mattybrad/drumkid2/media/images/panelimageexport.png

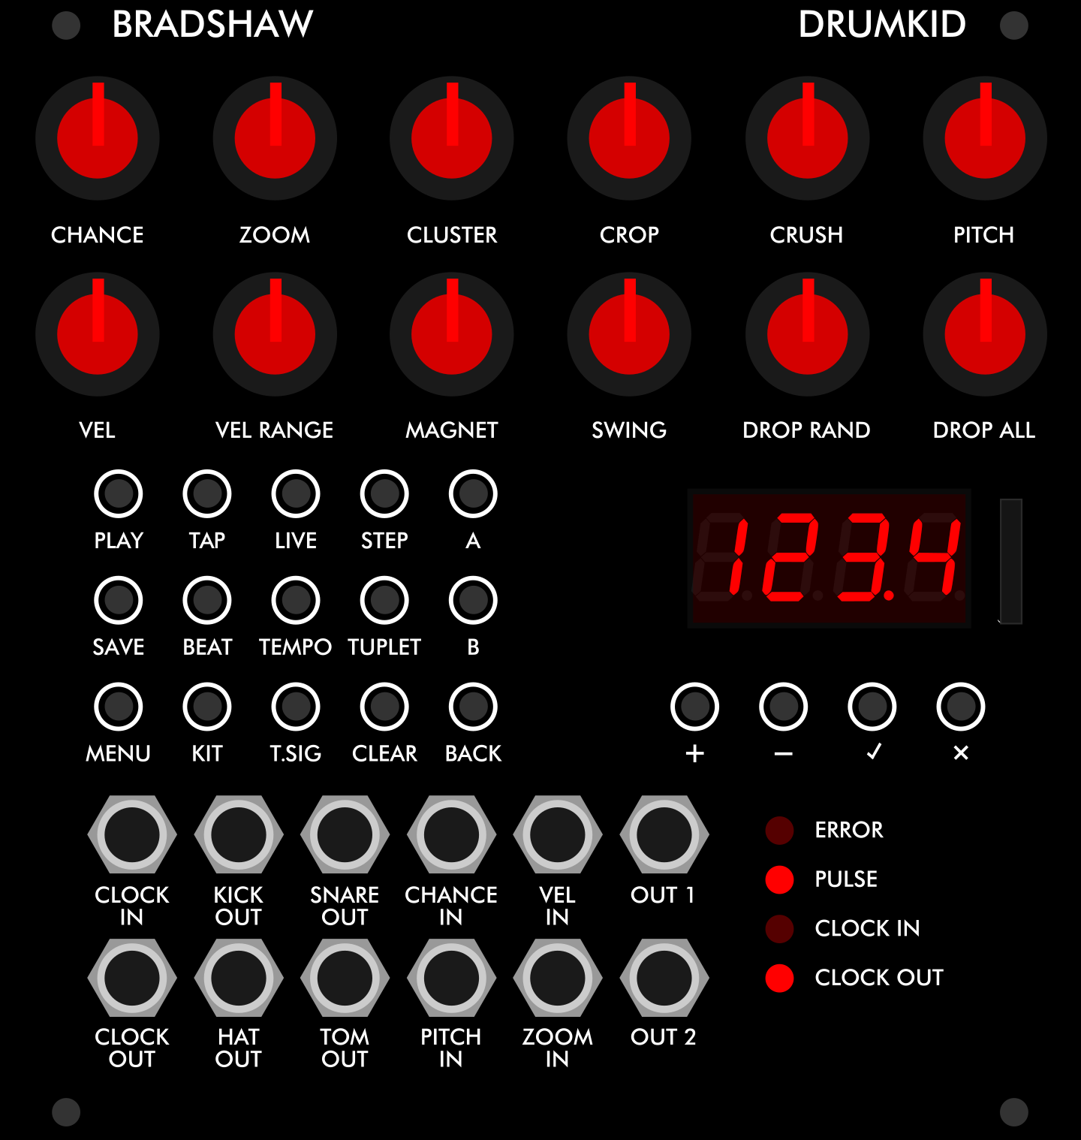
media/images/panelimageexport.png
