mattybrad/drumkid2/enclosure/eurorack/dk2_04_test.FCStd

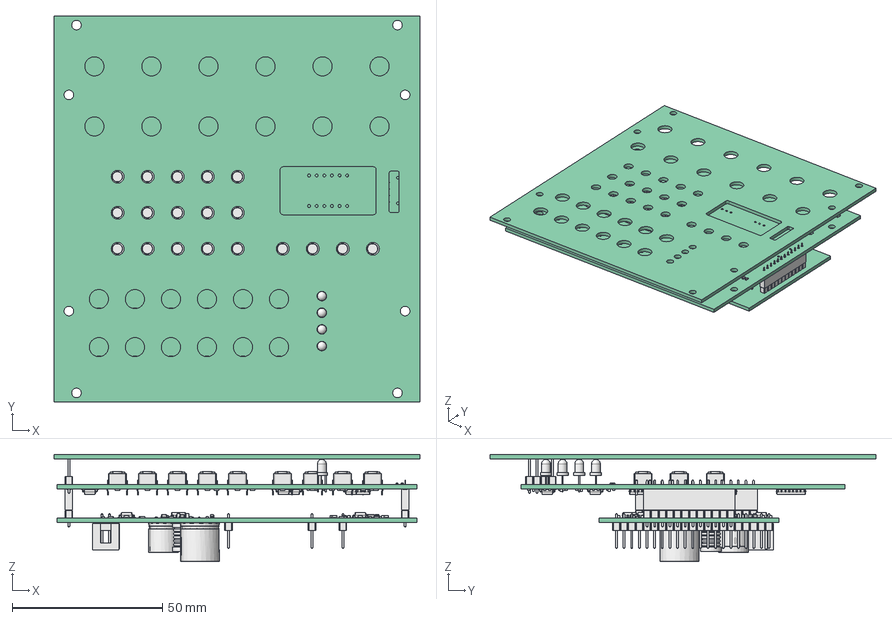
[picture p2: CAD file, 2025-03-11]
enclosure/eurorack/dk2_04_test.FCStd
121.9 x 128.5 x 35.8 mm
Pcb_6fe8
R11_R_0603_1608Metric_568fa190395a x 30
U4_TSSOP_20_44x65mm_P065mm_1e9c9b3e8fcb
U8_SOIC_8_39x49mm_P127mm_8803a6aed0f0 x 5
C3_C_0603_1608Metric_a1dab536839c x 25
J1_PinHeader_1x16_P254mm_Vertical_922e0c858e7e
D3_D_SOD_323_6214f62f95dd x 2
U2_SOT_23_0632b1590d94 x 2
J2_PinHeader_1x12_P254mm_Vertical_f6d6b4c187ef
C28_CP_Radial_D130mm_P500mm_ecaefe393f6c
J3_IDC_Header_2x05_P254mm_Vertical_50bdde54b574
L1_L_Radial_D7.0mm_P3.00mm_40ad14d131ec
J4_PinHeader_1x20_P254mm_Vertical_e00578f8c755 x 2
C27_CP_Radial_D80mm_P350mm_0c95952084c7
C25_CP_Radial_D100mm_P500mm_90115cc70ddc
J6_PinHeader_1x03_P254mm_Vertical_6c098004085a
Pcb_d942
SW10_SW_PUSH_6mm_a04f14d90740 x 19
D3_LED_D3.0mm_38c63c7e5b48 x 4
R45_R_0603_1608Metric_0fdf1b936cea x 45
J16_PinHeader_1x04_P254mm_Vertical_5d51ec4c8518
J7_PinSocket_1x12_P254mm_Vertical_d1941066af14
U6_SOIC_16_39x99mm_P127mm_10dee03ec1e1 x 7
C4_C_0603_1608Metric_d44bcf60c2ce x 4
J1_PinSocket_1x16_P254mm_Vertical_4846281b7eb6
U7_SOIC_8_39x49mm_P127mm_5dd7fafe9875 x 2
Pcb_edf2
