mattybrad/drumkid2/misc/displaypadtool/displaypadtool.FCStd

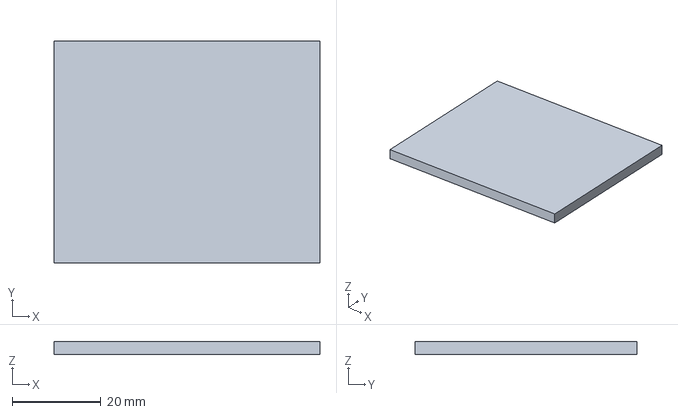
[picture p3: CAD file, 2025-08-04]
misc/displaypadtool/displaypadtool.FCStd
60.0 x 50.0 x 3.00 mm
