mattybrad/drumkid2/(list of files, cad)

Other CAD files:
pcb/dk2_06_panel/dk2_04_panel-F_Silkscreen.dxf
