mattybrad/drumkid2/code/bugs.txt

BUGS TO FIX
- Live beat input is not great, can't really do tuplets, kinda unreliable
- Rogue random hits with chance=0 and magnet>0 (and magnet<4095) with time signatures>4, drawing for wrong bit of memory...
- Metronome shouldn't be crushed?

FEATURES TO ADD
- Add 24PPQN (somehow) because it's common
- Live input undo?
- Separate trigger pulse length setting
- Program selection of default beats
- Finalise default kit and three(?) other kits for beta testers
- Dedicated back button?
- Live input quantize setting working
- Scrolling text for settings menu
POST-BETA FEATURES (non-essential)
- Reinitializing flash seems to leave vestige of old samples
- "Debouncing"(?) on drop pot, stays in current mode until definite change
- Fractional tempos (e.g. 120.1BPM)
- Allow stereo samples (load as mono)
- Allow other sample rates
- Backup beats to SD
- Better pitch lerping (not correct in reverse..?)
- Prioritise more recent(?) notes in reverse to give expected sound at higher zooms
- Use true midpoint of bizarrely asymmetrical pots! Like 1900/2000 rather than 2048?
