mattybrad/drumkid2/code/defaultsamples.h

#ifndef DEFAULTSAMPLES_H
#define DEFAULTSAMPLES_H

const int16_t defaultKick[] = {
    0,
    8,
    -44,
    485,
    2316,
    4103,
    5672,
    7048,
    8303,
    9439,
    10501,
    11486,
    12406,
    13282,
    14111,
    14932,
    15704,
    16433,
    17125,
    17773,
    18405,
    18995,
    19554,
    20094,
    20590,
    21078,
    21512,
    21940,
    22331,
    22713,
    23065,
    23398,
    23715,
    24008,
    24281,
    24539,
    24763,
    24995,
    25193,
    25372,
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
};

const int16_t defaultSnare[] = {
    29,
    159,
    283,
    -81,
    -587,
    523,
    3636,
    5972,
    4977,
    1540,
    -1683,
    -3526,
    -4632,
    -5617,
    -6289,
    -6286,
    -5608,
    -4499,
    -3176,
    -1831,
    -657,
    264,
    1033,
    1796,
    2531,
    3032,
    3145,
    2984,
    2875,
    3086,
    3628,
    4253,
    4605,
    4448,
    3835,
    3039,
    2311,
    1713,
    1199,
    774,
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
};

const int16_t defaultHat[] = {
    13,
    -143,
    -98,
    5,
    428,
    638,
    -478,
    -560,
    1136,
    1807,
    1305,
    -163,
    -2225,
    -2879,
    -420,
    2715,
    1925,
    -2138,
    -3389,
    -507,
    1587,
    1154,
    -1315,
    -2266,
    1587,
    3539,
    458,
    -1095,
    -3389,
    -5127,
    2475,
    7833,
    1501,
    -3852,
    -1933,
    460,
    180,
    -588,
    -1854,
    -1802,
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
};

const int16_t defaultTom[] = {
    -78,
    -51,
    -83,
    -21,
    -78,
    1577,
    4791,
    7761,
    10499,
    12741,
    14594,
    16010,
    17106,
    17891,
    18467,
    18824,
    19023,
    19127,
    19124,
    19050,
    18935,
    18756,
    18558,
    18327,
    18086,
    17811,
    17531,
    17241,
    16938,
    16632,
    16311,
    15992,
    15668,
    15336,
    15000,
    14663,
    14321,
    13979,
    13635,
    13287,
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
};

const int16_t* defaultSamples[4] = {defaultKick, defaultSnare, defaultHat, defaultTom};
int16_t defaultSampleSizes[4] = {
    sizeof(defaultKick) / 2,
    sizeof(defaultSnare) / 2,
    sizeof(defaultHat) / 2,
    sizeof(defaultTom) / 2,
};

#endif
