mattybrad/drumkid2/firmware/dkeuro2/hardware/Leds.cpp

#include "Leds.h"
#include "Config.h"
#include "sn74595.pio.h"
#include "hardware/Pins.h"
#include "hardware/gpio.h"

Leds* Leds::_instance = nullptr;

void Leds::init() {
    _instance = this;
    // Initialize LED hardware
    gpio_init(Pins::SR_OUT_DATA);
    gpio_set_dir(Pins::SR_OUT_DATA, GPIO_OUT);
    gpio_init(Pins::SR_OUT_CLOCK);
    gpio_set_dir(Pins::SR_OUT_CLOCK, GPIO_OUT);
    gpio_init(Pins::SR_OUT_LATCH);
    gpio_set_dir(Pins::SR_OUT_LATCH, GPIO_OUT);
    sn74595::shiftreg_init();
    _singleLedStates = 0;
    _segmentData[0] = 0b11000000;
    _segmentData[1] = 0b00110000;
    _segmentData[2] = 0b00001100;
    _segmentData[3] = 0b00000011;
}

void Leds::setLed(uint8_t ledNum, bool state) {
    // Set individual LED state
    if(state) {
        _singleLedStates |= (1 << (3-ledNum));
    } else {
        _singleLedStates &= ~(1 << (3-ledNum));
    }
}

void Leds::sendLedPulse(uint8_t ledNum, absolute_time_t startTimeUs) {
    if(ledNum >= NUM_LEDS) return;

    void *userData = (void*)(uintptr_t)ledNum;
    add_alarm_at(startTimeUs, _alarmCallbackHigh, userData, true);
    add_alarm_at(startTimeUs + (_pulseLengthMs * 1000), _alarmCallbackLow, userData, true);
}

int64_t Leds::_alarmCallbackHigh(alarm_id_t id, void* userData) {
    uint8_t ledNum = (uint8_t)(uintptr_t)userData;
    _instance->setLed(ledNum, true);

    return 0; // no need to repeat
}

int64_t Leds::_alarmCallbackLow(alarm_id_t id, void* userData) {
    uint8_t ledNum = (uint8_t)(uintptr_t)userData;
    _instance->setLed(ledNum, false);

    return 0; // no need to repeat
}

void Leds::setDisplayDigit(uint8_t digitNum, uint8_t digitSegmentData) {
    // Set 7-segment display data
    if(digitNum < 4) {
        _segmentData[digitNum] = digitSegmentData;
    }
}

void Leds::setDisplayString(const char* str) {
    bool stringFinished = false;
    for(uint8_t i=0; i<4; i++) {
        if(str[i] == '\0') stringFinished = true;
        setDisplayDigit(i, stringFinished ? 0 : asciiChars[(uint8_t)str[i]]);
    }
}

void Leds::setDisplayInt(int32_t number) {
    // Display integer on 7-segment display
    
    // todo: handle negative and >9999

    for(uint8_t i=0; i<4; i++) {
        uint8_t digitValue = number % 10;
        if(number == 0 && i > 0) {
            setDisplayDigit(3-i, asciiChars[0]); // leading zeros as blank
        } else {
            setDisplayDigit(3-i, asciiChars['0' + digitValue]);
        }
        number /= 10;
    }
}

void Leds::setDisplayNumberFP(int32_t numberFP, uint8_t decimalPlaces) {
    // Display fixed point number on 7-segment display, with specified decimal places
    int32_t adjustedNumber = numberFP;
    for(uint8_t i=0; i<decimalPlaces; i++) {
        adjustedNumber *= 10;
    }
    adjustedNumber = adjustedNumber >> 16;
    for(uint8_t i=0; i<4; i++) {
        uint8_t digitValue = adjustedNumber % 10;
        bool isDecimalPoint = (i == decimalPlaces && decimalPlaces > 0);
        bool isLeadingZero = (adjustedNumber == 0 && i >= decimalPlaces);
        setDisplayDigit(3-i, asciiChars[isLeadingZero ? 0 : '0' + digitValue] + (isDecimalPoint ? 0b10000000 : 0)); // add decimal point to appropriate digit
        adjustedNumber /= 10;
    }
} 

void Leds::update() {
    // Update LED states on hardware
    // first 8 bits toggle segments, next 4 bits toggle digits, last 4 bits toggle LEDs
    uint16_t shiftRegData = 0b0000111100000000;
    shiftRegData |= (_singleLedStates << 12);
    shiftRegData |= _segmentData[_currentDigit];
    shiftRegData &= ~(1 << (8+_currentDigit)); // set selected digit low
    sn74595::shiftreg_send(shiftRegData);
    _currentDigit = (_currentDigit + 1) % 4;
    _lastUpdateTime = time_us_64();
}

void Leds::specialUpdateBeforeBlockingProcess() {
    // sets all digits to "_" to indicate processing
    uint16_t shiftRegData = 0b0000000000001000;
    shiftRegData |= (_singleLedStates << 12);
    sn74595::shiftreg_send(shiftRegData);
}

int64_t Leds::lastUpdate() {
    return _lastUpdateTime;
}

uint8_t Leds::asciiChars[] = {
    0b00000000, // 0 NULL
    0b00000000,
    0b00000000,
    0b00000000,
    0b00000000,
    0b00000000,
    0b00000000,
    0b00000000,
    0b00000000,
    0b00000000,
    0b00000000,
    0b00000000,
    0b00000000,
    0b00000000,
    0b00000000,
    0b00000000,
    0b00000000,
    0b00000000,
    0b00000000,
    0b00000000,
    0b00000000,
    0b00000000,
    0b00000000,
    0b00000000,
    0b00000000,
    0b00000000,
    0b00000000,
    0b00000000,
    0b00000000,
    0b00000000,
    0b00000000,
    0b00000000,
    0b00000000, // 32 SPACE
    0b00000000,
    0b00000000,
    0b00000000,
    0b00000000,
    0b00000000,
    0b00000000,
    0b00000000,
    0b00000000,
    0b00000000,
    0b00000000,
    0b00000000,
    0b00000000,
    0b01000000, // -
    0b10000000, // .
    0b00000000,
    0b00111111, // digit 0
    0b00000110,
    0b01011011,
    0b01001111,
    0b01100110,
    0b01101101,
    0b01111101,
    0b00000111,
    0b01111111,
    0b01101111, // digit 9
    0b00000000,
    0b00000000,
    0b00000000,
    0b00000000,
    0b00000000,
    0b01010011,
    0b00000000, // 64
    0b01110111, // A (a)
    0b01111100,
    0b00111001,
    0b01011110,
    0b01111001,
    0b01110001,
    0b01101111,
    0b01110110,
    0b00000110,
    0b00001111,
    0b01110110,
    0b00111000,
    0b00110111,
    0b01010100,
    0b01011100,
    0b01110011,
    0b01100111,
    0b01010000,
    0b01101101,
    0b01111000,
    0b00111110,
    0b00011100,
    0b00111110,
    0b01110110,
    0b01101110,
    0b01011011, // Z (z)
    0b00000000,
    0b00000000,
    0b00000000,
    0b00000000,
    0b00001000, // _
    0b00000000, // 96
    0b01110111, // a
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
};
