mattybrad/drumkid2/code/defaultbeats.h

#ifndef DEFAULTBEATS_H
#define DEFAULTBEATS_H

#define NUM_DEFAULT_BEATS 24

constexpr uint32_t defaultBeats[NUM_DEFAULT_BEATS][NUM_SAMPLES] = {
    {
        0b00000000000000000000000000000000,
        0b00000000000000000000000000000000,
        0b10001000100010001000100010001000,
        0b00000000000000000000000000000000,
    },
    {
        0b00000000000000000000000000000000,
        0b00000000000000000000000000000000,
        0b10101010101010101010101010101010,
        0b00000000000000000000000000000000,
    },
    {
        0b10000000100000000000000000000000,
        0b00001000000010000000000000000000,
        0b10101010101010101010101010101010,
        0b00000000000000000000000000000000,
    },
    {
        0b10000000000000000000000000000000,
        0b00000000100000000000000000000000,
        0b10001000100010001000100010001000,
        0b00000000000000000000000000000000,
    },
    { // there there
        0b10000010001000001000001000100000,
        0b00001000000010000000100000001000,
        0b10101010101010101010101010101010,
        0b00001000000010000000100000001000,
    },
    { // metal
        0b11110111111101111111011111110111,
        0b00001000000010000000100000001000,
        0b10001000100010001000100010001000,
        0b00000000000000000000000000000000,
    },
    { // four to the floor
        0b10001000100010001000100010001000,
        0b00000000000000000000000000000000,
        0b00000000000000000000000000000000,
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
    },
    { // nihil (could possibly remove this to save some bytes)
        0b00000000000000000000000000000000,
        0b00000000000000000000000000000000,
        0b00000000000000000000000000000000,
        0b00000000000000000000000000000000,
    },
};

#endif
