mattybrad/drumkid2/firmware/dkeuro2/interface/Menu.h

#pragma once
#include <array>
#include "hardware/Leds.h"
#include "hardware/Memory.h"
#include "hardware/CardReader.h"
#include "audio/KitManager.h"
#include "rhythm/Transport.h"
#include "Config.h"

enum class MenuState {
    HOME,
    TAP_TEMPO,
    LIVE_EDIT,
    STEP_EDIT,
    BEAT_SELECT,
    MANUAL_TEMPO,
    TUPLET_SELECT,
    SUBMENU_SELECTING,
    INPUT_PPQN_SELECT,
    OUTPUT_PPQN_SELECT,
    CLOCK_MODE_SELECT,
    KIT_LOAD_FOLDER_SELECT,
    KIT_LOAD_SLOT_SELECT,
    KIT_DELETE,
    KIT_SELECT,
    TIME_SIGNATURE_SELECT,
    CHECK_SPACE
};


class Menu {
    public:
        void init(Leds* leds, Memory* memory, CardReader* cardReader, KitManager* kitManager, Transport* transport);
        void handleButtonPress(int16_t buttonIndex);
        void forceDisplayUpdate();
    
    private:
        Leds* _leds = nullptr;
        Memory* _memory = nullptr;
        CardReader* _cardReader = nullptr;
        KitManager* _kitManager = nullptr;
        Transport* _transport = nullptr;
    
        MenuState _state = MenuState::HOME;
        uint8_t _subMenuIndex = 0;
        uint16_t _kitLoadFolderIndex = 0;
        uint16_t _kitLoadSlot = 0;
        std::array<MenuState, 6> _subMenuStates = {
            MenuState::CLOCK_MODE_SELECT,
            MenuState::KIT_LOAD_FOLDER_SELECT,
            MenuState::KIT_DELETE,
            MenuState::CHECK_SPACE,
            MenuState::INPUT_PPQN_SELECT,
            MenuState::OUTPUT_PPQN_SELECT,
        };

        void _handleButtonGeneral(int16_t buttonIndex);
        void _handleButtonKitSelect(int16_t buttonIndex);
        void _handleButtonManualTempo(int16_t buttonIndex);
        void _handleButtonSubMenuSelecting(int16_t buttonIndex);
        void _handleButtonKitLoadFolderSelect(int16_t buttonIndex);
        void _handleButtonKitLoadSlotSelect(int16_t buttonIndex);
        void _handleButtonKitDelete(int16_t buttonIndex);
        void _handleButtonCheckSpace(int16_t buttonIndex);
        void _handleButtonClockModeSelect(int16_t buttonIndex);
        void _handleButtonTimeSignatureSelect(int16_t buttonIndex);
        void _updateDisplay();
};
