mattybrad/drumkid2/(commit log)

2022-09-08 pico submodules
2022-09-08 pico pcb
    [dk2_00.kicad_pcb, dk2_00.kicad_sch]
2023-01-16 figuring out specs
    [dk2_00.kicad_sch]
2023-01-17 good progress on schematic
    [dk2_00.kicad_sch]
2023-01-17 more schematic progress
    [dk2_00.kicad_sch]
2023-01-18 even more schematic
    [dk2_00.kicad_sch]
2023-02-07 something, can't remember
    [dk2_00.kicad_sch]
2023-04-11 haven't committed for a while...
    [dk2_00.kicad_sch]
2023-04-11 did some things
    [dac.kicad_sch, dk2_00.kicad_sch, midi.kicad_sch, muxin.kicad_sch, shiftregin.kicad_sch, shiftregout.kicad_sch, sync.kicad_sch]
2023-04-20 i'm back!
    [dac.kicad_sch, dk2_00.kicad_sch, midi.kicad_sch, muxin.kicad_sch, shiftregin.kicad_sch, shiftregout.kicad_sch, sync.kicad_sch]
2023-04-20 eurorack thoughts
    [cv.kicad_sch, dk2_00.kicad_sch, sync.kicad_sch]
2023-04-21 oh that's what a multi unit symbol is
    [dac.kicad_sch, dk2_00.kicad_sch, midi.kicad_sch, muxin.kicad_sch, shiftregin.kicad_sch, shiftregout.kicad_sch, sync.kicad_sch]
2023-04-21 not many errors
    [dac.kicad_sch, dk2_00.kicad_sch, midi.kicad_sch, muxin.kicad_sch, shiftregin.kicad_sch, shiftregout.kicad_sch, sync.kicad_sch]
2023-04-23 footprints assigned
    [dac.kicad_sch, dk2_00.kicad_pcb, dk2_00.kicad_sch, midi.kicad_sch, muxin.kicad_sch, shiftregin.kicad_sch, shiftregout.kicad_sch, sync.kicad_sch]
2023-04-25 changed jack sockets
    [dac.kicad_sch, dk2_00.kicad_pcb, midi.kicad_sch, sync.kicad_sch]
2023-04-25 eurorack power stuff
    [dk2_00.kicad_sch, europower.kicad_sch, sync.kicad_sch]
2023-04-27 power things?
    [dk2_00.kicad_sch, europower.kicad_sch]
2023-04-27 making a mess
    [cv_in.kicad_sch, cv_out.kicad_sch, dk2_00.kicad_sch, europower.kicad_sch]
2023-04-28 nothing much
    [cv_in.kicad_sch, cv_out.kicad_sch]
2023-05-02 being decisive
    [dac.kicad_sch, europower.kicad_sch, midi.kicad_sch, shiftregin.kicad_sch, shiftregout.kicad_sch, sync.kicad_sch]
2023-05-02 eurorack audio out
    [dac.kicad_sch, dk2_00.kicad_sch, muxin.kicad_sch]
2023-05-03 i'm doing electronics!
    [dac.kicad_sch, dk2_00.kicad_sch, muxin1.kicad_sch, muxin2.kicad_sch]
2023-05-04 tidying up, getting close!
    [dac.kicad_sch, dk2_00.kicad_sch, europower.kicad_sch, midi.kicad_sch, muxin1.kicad_sch, muxin2.kicad_sch, shiftregin.kicad_sch, shiftregout.kicad_sch]
2023-05-04 barrel jack, power pins
    [dk2_00.kicad_sch, muxin2.kicad_sch, power.kicad_sch]
2023-05-04 rough layout
    [dk2_00.kicad_pcb, muxin1.kicad_sch]
2023-05-05 this layout is complicated!
    [dac.kicad_sch, dk2_00.kicad_pcb, dk2_00.kicad_sch, midi.kicad_sch, muxin2.kicad_sch, power.kicad_sch, sync.kicad_sch]
2023-05-05 more layout
    [dk2_00.kicad_pcb]
2023-05-15 getting there with the layout
    [dk2_00.kicad_pcb]
2023-05-17 about to start routing i guess?
    [dk2_00.kicad_pcb]
2023-05-17 161 still unrouted
    [dk2_00.kicad_pcb]
2023-05-17 76 unrouted
    [dk2_00.kicad_pcb]
2023-05-18 only 12 unrouted but discovered a mistake
    [dk2_00.kicad_pcb]
2023-05-18 zero unconnected!
    [dac.kicad_sch, dk2_00.kicad_pcb]
2023-05-21 tidied up layout
    [dk2_00.kicad_pcb]
2023-05-23 it's jlc time
    [dac.kicad_sch, dk2_00.kicad_pcb, dk2_00.kicad_sch, midi.kicad_sch, muxin2.kicad_sch, power.kicad_sch, sync.kicad_sch]
2023-05-23 nearly there with jlcpcb, one footprint was wrong
    [dac.kicad_sch, dk2_00.kicad_pcb]
2023-05-23 faffing with bom
2023-05-31 ordered PCBs, mistake on MIDI input optocoupler
    [midi.kicad_sch]
2023-06-05 logging some broken/modded stuff now the pcb is working
    [dac.kicad_sch, dk2_00.kicad_sch, power.kicad_sch, sync.kicad_sch]
2023-06-07 it plays samples!
2023-06-08 testing board in c
    [shiftregin.kicad_sch]
2023-06-08 cv pitch shifting working
2023-06-16 some weird timing error with LEDs but promising nonetheless
    [Beat.h, dk.cpp]
2023-06-16 leds working nicely
2023-06-19 making led and button functions a bit nicer
2023-06-20 solved temperamental 4051 readings
    [muxin1.kicad_sch, muxin2.kicad_sch]
2023-08-15 started eurorack pcb
    [cv.kicad_sch, cv_in.kicad_sch, cv_out.kicad_sch, dac.kicad_sch, dk2_01.kicad_pcb, dk2_01.kicad_sch, europower.kicad_sch, midi.kicad_sch]
2023-08-15 good pcb progress
    [dac.kicad_sch, dk2_01.kicad_sch, muxin1.kicad_sch, muxin2.kicad_sch, shiftregout.kicad_sch, sync.kicad_sch]
2023-08-15 going for a picnic
    [dac.kicad_sch, dk2_01.kicad_pcb, dk2_01.kicad_sch, muxin1.kicad_sch, muxin2.kicad_sch, power.kicad_sch, shiftregin.kicad_sch, shiftregout.kicad_sch]
2023-08-16 pcb layout going well
    [dac.kicad_sch, dk2_01.kicad_pcb, dk2_01.kicad_sch, muxin2.kicad_sch, power.kicad_sch, shiftregout.kicad_sch, sync.kicad_sch]
2023-08-16 there is a lot of stuff on this pcb
    [dk2_01.kicad_pcb]
2023-08-16 tweaking the front panel based on the pcb
    [dac.kicad_sch, dk2_01.kicad_pcb, muxin2.kicad_sch, sync.kicad_sch]
2023-08-16 more layout tweaks
    [dk2_01.kicad_pcb, power.kicad_sch, shiftregout.kicad_sch]
2023-08-21 changing design to double-decker pcb for compactness
    [cv.kicad_sch, cv_in.kicad_sch, cv_out.kicad_sch, dac.kicad_sch, digital-in-out.kicad_sch, dk2_02_bottom.kicad_pcb, dk2_02_bottom.kicad_sch, europower.kicad_sch]
2023-08-23 bottom pcb looks fairly easy
    [dac.kicad_sch, digital-in-out.kicad_sch, dk2_02_bottom.kicad_pcb, dk2_02_bottom.kicad_sch, power.kicad_sch]
2023-08-23 started top side pcb
    [cv.kicad_sch, cv_in.kicad_sch, cv_out.kicad_sch, dac.kicad_sch, dk2_02_bottom.kicad_pcb, dk2_02_top.kicad_pcb, dk2_02_top.kicad_sch, europower.kicad_sch]
2023-08-23 done for the week, started routing
    [dac.kicad_sch, dk2_02_bottom.kicad_pcb, dk2_02_bottom.kicad_sch, dk2_02_top.kicad_pcb, dk2_02_top.kicad_sch, muxin2.kicad_sch]
2023-08-29 routing again
    [dk2_02_top.kicad_pcb]
2023-08-29 nearly routed
    [dk2_02_top.kicad_pcb]
2023-08-29 top routing done
    [dk2_02_bottom.kicad_pcb, dk2_02_top.kicad_pcb, dk2_02_top.kicad_sch]
2023-08-29 started component placement on bottom board
    [dk2_02_bottom.kicad_pcb]
2023-08-30 bottom pcb placement done
    [dk2_02_bottom.kicad_pcb]
2023-08-30 bottom routing mainly done
    [dk2_02_bottom.kicad_pcb]
2023-08-30 routing done
    [dk2_02_bottom.kicad_pcb]
2023-08-30 ready for jlcpcb
    [dk2_02_bottom-CuBottom.gbr, dk2_02_bottom-CuTop.gbr, dk2_02_bottom-EdgeCuts.gbr, dk2_02_bottom-MaskBottom.gbr, dk2_02_bottom-MaskTop.gbr, dk2_02_bottom-NPTH.drl, dk2_02_bottom-PTH.drl, dk2_02_bottom-PasteBottom.gbr]
2023-09-05 panel nearly done
    [dk2_02_panel.kicad_pcb, dk2_02_panel.kicad_sch]
2023-09-05 front panel done
    [dk2_02_panel-CuBottom.gbr, dk2_02_panel-CuTop.gbr, dk2_02_panel-EdgeCuts.gbr, dk2_02_panel-MaskBottom.gbr, dk2_02_panel-MaskTop.gbr, dk2_02_panel-NPTH.drl, dk2_02_panel-PTH.drl, dk2_02_panel-PasteBottom.gbr]
2023-10-11 assembling the pcb 2.02
    [dac.kicad_sch]
2023-10-18 pcb looking good so far
2023-11-08 sd sample loading works (messy for now)
2023-11-08 LEDs working much better now
2023-11-10 input/output handling now done with timers, much cleaner
2023-11-17 started flash storage stuff, hitting usb conflict issues?
    [dk.cpp]
2023-11-21 upgraded to the latest pico toolchain and tidied up code directory
2023-11-21 restored samples
2023-11-28 mainly fixed SD conflict
    [drumkid.cpp]
2023-11-28 sample loading from WAV file works really nicely!
2023-11-28 currently a mess, trying to move samples to flash
2023-12-04 figured out the flash erase issue
    [drumkid.cpp]
2023-12-04 now loading entire sample set from SD to flash to RAM
2023-12-05 tempo now stored when beat stops, also some bugfixes
    [drumkid.cpp, drumkid.h]
2023-12-12 reworking the hit scheduling system to allow swing and random timing
    [drumkid.cpp, drumkid.h]
2024-01-08 tired evening coding
2024-01-16 trying to find an annoying bug, making a mess
    [Sample.h, drumkid.cpp]
2024-01-22 fixed issue with initial hits on start
    [Sample.h, drumkid.cpp]
2024-01-22 sync out timing fixed
    [drumkid.cpp]
2024-01-23 replaced janky timer system with proper alarm pool stuff
    [Sample.h, drumkid.cpp, drumkid.h]
2024-01-30 can handle longer samples
2024-02-06 fixed tuplet map for beats
    [Beat.h, constants.h, drumkid.h]
2024-02-09 finding/fixing(?) some high-speed bugs
    [dac.kicad_sch, dk2_02_top.kicad_sch, shiftregout.kicad_sch]
2024-02-09 started adding pitch functionality, was too slow, need to rethink
    [Sample.h, drumkid.cpp, drumkid.h]
2024-02-12 switched sample position/speed stuff from floats to ints
2024-02-12 lerping! much better pitch effect
2024-02-12 reverse sample playback
2024-02-16 temporarily removing velocity functions to stress test scheduling speed
2024-02-27 reimplemented pitch, fixed fade out
    [Sample.h, constants.h, drumkid.cpp, drumkid.h]
2024-02-27 started trying to figure out reverse sample offset, got tired
    [Sample.h, drumkid.cpp, drumkid.h]
2024-03-04 successfully loaded 8 samples but tempo slowed down
2024-03-05 started pitch dead zone
2024-03-19 negative velocity
2024-03-26 more robust sd card error handling etc
    [drumkid.cpp, drumkid.h]
2024-04-10 ppqn output setting, clear current beat
2024-05-17 pitch knob behaviour improvement
    [muxin1.kicad_sch]
2024-05-17 better chance implementation, first attempt at magnet
2024-05-22 so close to magnet function working but not quite right with discontinuity right now
2024-05-24 magnet works okay
2024-05-31 revert beat to previous saved version
    [drumkid.cpp, drumkid.h]
2024-05-31 new bottom pcb
    [cv.kicad_sch, cv_in.kicad_sch, cv_out.kicad_sch, dac.kicad_sch, digital-in-out.kicad_sch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]
2024-06-03 alphabetical sample folder listing
2024-06-04 bootup visuals, error handling, status LEDs
    [drumkid.cpp, drumkid.h]
2024-06-06 led pulse length fix
    [drumkid.cpp, drumkid.h]
2024-06-28 getting ready for next PCBs
    [cv.kicad_sch, cv_in.kicad_sch, cv_out.kicad_sch, dac.kicad_sch, dk2_03_bottom.kicad_pcb, dk2_03_bottom.kicad_sch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]
2024-07-01 pcb progress
    [dk2_03_bottom.kicad_sch, dk2_03_top.kicad_sch, power.kicad_sch, shiftregin.kicad_sch, shiftregout.kicad_sch]
2024-07-02 bottom pcb shrunk
    [dk2_03_bottom.kicad_pcb, dk2_03_bottom.kicad_sch, dk2_03_top.kicad_sch]
2024-07-02 a commit before i mess up all the buttons
    [dac.kicad_sch, digital-in-out.kicad_sch, dk2_03_bottom.kicad_pcb, dk2_03_bottom.kicad_sch, dk2_03_top.kicad_pcb, dk2_03_top.kicad_sch, power.kicad_sch, shiftreginx.kicad_sch]
2024-07-05 routing top pcb
    [dk2_03_top.kicad_pcb, dk2_03_top.kicad_sch, muxin1.kicad_sch, muxin2.kicad_sch, shiftregin.kicad_sch, shiftreginx.kicad_sch, shiftregout.kicad_sch]
2024-07-05 top pcb routed
    [dk2_03_top.kicad_pcb, dk2_03_top.kicad_sch]
2024-07-05 routing bottom pcb
    [dk2_03_bottom.kicad_pcb, dk2_03_top.kicad_pcb]
2024-07-08 bottom pcb routed
    [dk2_03_bottom.kicad_pcb]
2024-07-08 front panel progress
    [dk2_03_panel-CuBottom.gbr, dk2_03_panel-CuTop.gbr, dk2_03_panel-EdgeCuts.gbr, dk2_03_panel-MaskBottom.gbr, dk2_03_panel-MaskTop.gbr, dk2_03_panel-NPTH.drl, dk2_03_panel-PTH.drl, dk2_03_panel-PasteBottom.gbr]
2024-07-08 fixed an issue where i forgot to rotate the pots on the pcb
    [dk2_03_panel.kicad_pcb, dk2_03_panel.kicad_sch, dk2_03_top.kicad_pcb]
2024-07-08 panel very nearly done
    [dk2_03_panel.kicad_pcb, dk2_03_panel.kicad_sch]
2024-07-09 panel finished!
    [dk2_03_panel.kicad_pcb, dk2_03_panel.kicad_sch]
2024-07-09 pcbs ordered
    [dk2_03_bottom-CuBottom.gbr, dk2_03_bottom-CuTop.gbr, dk2_03_bottom-EdgeCuts.gbr, dk2_03_bottom-MaskBottom.gbr, dk2_03_bottom-MaskTop.gbr, dk2_03_bottom-NPTH.drl, dk2_03_bottom-PTH.drl, dk2_03_bottom-PasteBottom.gbr]
2024-07-23 fixed sync out tuplet issue
    [drumkid.cpp]
2024-08-20 some good timing stability improvements
    [Sample.h, drumkid.cpp]
2024-08-23 tried something, it didn't work
    [drumkid.cpp, drumkid.h]
2024-09-03 things are not working well
    [drumkid.cpp]
2024-09-20 flash beat storage getting there, also sample loading
2024-09-27 slightly bodged sync output
    [drumkid.cpp]
2024-09-30 ppqn stuff and glitch effect
    [drumkid.cpp]
2024-10-04 button hold
2024-10-07 backup or revert beat
    [drumkid.cpp]
2024-10-14 restored velocity
2024-11-05 allowing other sample formats
2024-11-05 lower sample rates working
2024-11-05 added sample tails to reduce pop/click sounds
2024-11-18 figuring out how to do factory reset
    [Beat.h, defaultbeats.h, defaultsamples.h, drumkid.cpp, drumkid.h, sevensegcharacters.h]
2024-11-19 pot centre deadzones, fixed pulse display issue
    [drumkid.cpp, drumkid.h]
2024-11-22 magnet control working (that was annoying)
2024-11-22 fractional tempos, magnet fix
    [drumkid.cpp, drumkid.h]
2024-11-25 finally got button debouncing working properly
2024-11-26 fixed factory reset function
    [drumkid.cpp, drumkid.h]
2024-11-26 committing before i start messing about too much with timing stuff
    [drumkid.cpp]
2024-12-06 next pcb started
    [cv.kicad_sch, cv_in.kicad_sch, cv_out.kicad_sch, dac.kicad_sch, digital-in-out.kicad_sch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]
2024-12-10 power off stuff
    [dac.kicad_sch, digital-in-out.kicad_sch, dk2_04_bottom.kicad_sch, power.kicad_sch]
2024-12-13 pcb 2.04 tweaks
    [dk2_04_bottom.kicad_sch, power.kicad_sch, shiftreginx.kicad_sch]
2024-12-13 sample... samples
2025-02-17 panel improvements
    [dk2_04_panel.kicad_pcb, dk2_04_panel.kicad_sch]
2025-02-19 rejigged top board, smaller connectors
    [dk2_04_top.kicad_pcb, dk2_04_top.kicad_sch, shiftreginx.kicad_sch]
2025-03-11 autosave works
    [cv.kicad_sch, cv_in.kicad_sch, cv_out.kicad_sch, dac.kicad_sch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]
2025-03-19 making some progress on default samples without sd card
2025-05-15 haven't committed for ages because i did something stupid in git
    [cv.kicad_sch, cv_in.kicad_sch, cv_out.kicad_sch, dac.kicad_sch, digital-in-out.kicad_sch, digitalinout.kicad_sch, dk2_04_panel-F_Silkscreen.dxf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]
2025-05-15 all this layout stuff better be worth it
    [dac.kicad_sch, dk2_05.kicad_pcb, dk2_05_panel.kicad_pcb]
2025-05-15 layout starting to feel okay, routing will be bad..?
    [dk2_05.kicad_pcb]
2025-05-16 panel and pcb are aligned
    [dac.kicad_sch, digitalinout.kicad_sch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]
2025-05-16 started routing
    [dk2_05.kicad_pcb]
2025-05-19 routing going well
    [dk2_05.kicad_pcb]
2025-05-19 more routing
    [dk2_05.kicad_pcb]
2025-05-19 27 unrouted, nearly there...
    [dk2_05.kicad_pcb]
2025-05-20 jlcpcb stuff done
    [dk2_05-CuBottom.gbr, dk2_05-CuIn1.gbr, dk2_05-CuIn2.gbr, dk2_05-CuTop.gbr, dk2_05-EdgeCuts.gbr, dk2_05-MaskBottom.gbr, dk2_05-MaskTop.gbr, dk2_05-NPTH.drl]
2025-05-20 faffing with capacitors for jlc reasons
    [cv.kicad_sch, cv_in.kicad_sch, cv_out.kicad_sch, dac.kicad_sch, digital-in-out.kicad_sch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]
2025-08-04 pcb and panel v2.06, minor fixes
    [cv.kicad_sch, cv_in.kicad_sch, cv_out.kicad_sch, dac.kicad_sch, digitalinout.kicad_sch, displaypadtool.FCStd, dk2_04_panel-F_Silkscreen.dxf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]
2025-09-10 getting back into development...
    [dk2_06-CuBottom.gbr, dk2_06-CuIn1.gbr, dk2_06-CuIn2.gbr, dk2_06-CuTop.gbr, dk2_06-EdgeCuts.gbr, dk2_06-MaskBottom.gbr, dk2_06-MaskTop.gbr, dk2_06-NPTH.drl]
2025-09-30 new samples
2025-10-24 firmware todo list
    [cv.kicad_sch, cv_in.kicad_sch, cv_out.kicad_sch, dac.kicad_sch, digitalinout.kicad_sch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]
2025-12-01 pcb v2.07 nearly done
    [dk2_07.kicad_pcb, dk2_07.kicad_sch]
2025-12-01 better led placement
    [dk2_07.kicad_pcb]
2025-12-09 serial number silkscreen, assembly order adjusted
    [dk2_07.kicad_pcb]
2026-01-09 firmware v2 started
    [dk2_07.kicad_pcb]
2026-01-13 clock not working properly, making some changes...
    [dkeuro2.c]
2026-01-14 led functions working well
2026-01-14 an undignified mixture of v1 timing fixes and v2 led progress
    [Leds.cpp, Leds.h, dkeuro2.cpp, drumkid.cpp]
2026-01-15 led class working well
2026-01-15 buttons started
2026-01-16 fixed issue where metronome didn't play in ext clock mode
    [drumkid.cpp]
2026-01-19 disabling almost all alarm/timer/event stuff to try and keep things as stable as possible
2026-01-19 fixed issue where tempos above 999.9BPM didn't display correctly
    [drumkid.cpp]
2026-01-19 fixed issue where tempo was wrong when switching from external clock to internal
    [drumkid.cpp]
2026-01-23 looking at ways to do longer samples for v2 firmware
    [dk2_07-CuBottom.gbr, dk2_07-CuIn1.gbr, dk2_07-CuIn2.gbr, dk2_07-CuTop.gbr, dk2_07-EdgeCuts.gbr, dk2_07-MaskBottom.gbr, dk2_07-MaskTop.gbr, dk2_07-NPTH.drl]
2026-01-29 trying 8 samples, works well
2026-01-29 tried out ~20s of sample storage, works well
2026-01-30 moved hardware update code from timers to main loop for predictability
2026-01-30 fixed timing error with main loop hardware updates
    [dkeuro2.cpp]
2026-02-06 made a mess, testing buttons, kit loading, etc
2026-02-25 some progress with wav parser but 24 bit samples broken
    [CardReader.cpp, dkeuro2.cpp]
2026-02-27 24 bit samples read!
2026-03-03 better button handling, 7-segment improvements
2026-03-27 need to fix some memory stuff
    [CardReader.cpp, CardReader.h, Menu.cpp]
2026-04-07 some kit loads cause invalid metadata and hence reset, need to figure out why
    [Config.h, Memory.cpp, Memory.h]
2026-04-13 fixed invalid metadata, kit loading works nicely!
    [Memory.h, Menu.cpp]
2026-04-15 settings save works on power off
2026-04-16 started playing with pitch control
2026-04-17 velocity implemented
2026-04-24 switching timing system from fixed PPQN to Q16.16
    [Aleatory.cpp, Aleatory.h, Beat.cpp, Beat.h, Transport.cpp, Transport.h, dkeuro2.cpp]
2026-06-18 can now switch between clock modes
2026-07-07 display/LED improvements
